lilywang899/gripper/README.md

# Gripper
Using two [KGM1024-N20](https://www.kindmotor.com/sale-26563852-micro-parallel-axis-shaft-dc-motor-180mnm-2-2w-right-angle-gear-reducer-motor.html) motors,
 resistive position sensors, and ESP32 controller, the gripper interfaces with a robotic arm to grasp small objects.

#### Detailed PCB soldering and troubleshooting process can be found [here](./hardware/README.md)
