lilywang899/gripper/3D-model/case.SLDPRT

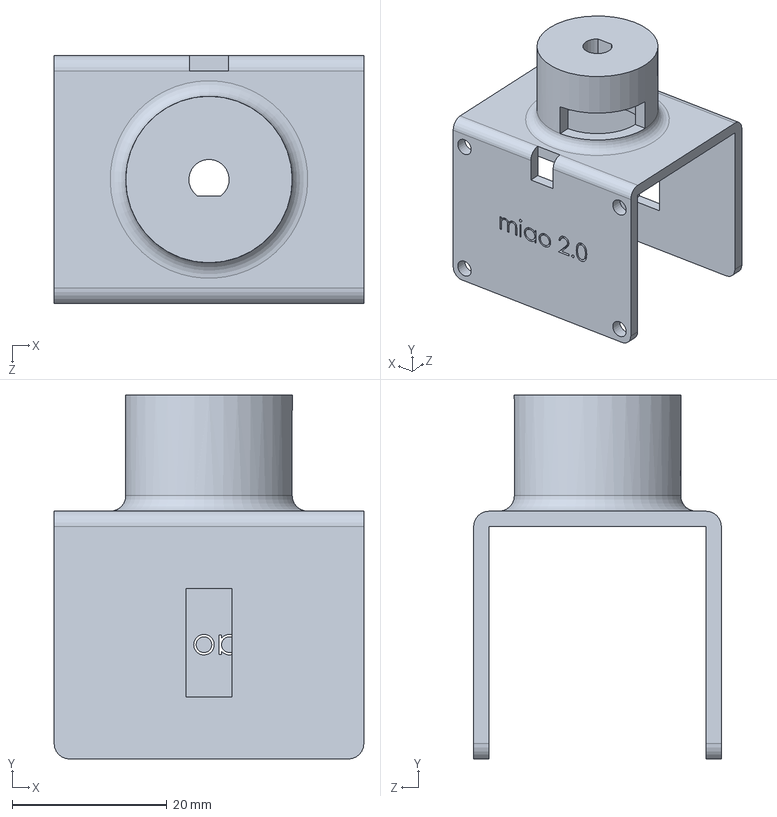
[picture p4: CAD file, 2025-09-13]
3D-model/case.SLDPRT
40.0 x 47.0 x 32.0 mm
