lilywang899/gripper/3D-model/collar_clamp_for_case.SLDPRT

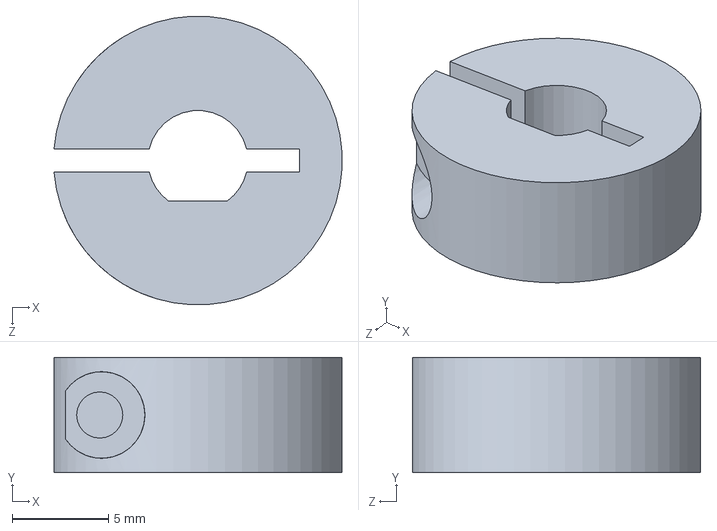
[picture p5: CAD file, 2025-09-13]
3D-model/collar_clamp_for_case.SLDPRT
15.0 x 6.00 x 15.0 mm
