lilywang899/gripper/3D-model/finger.SLDPRT

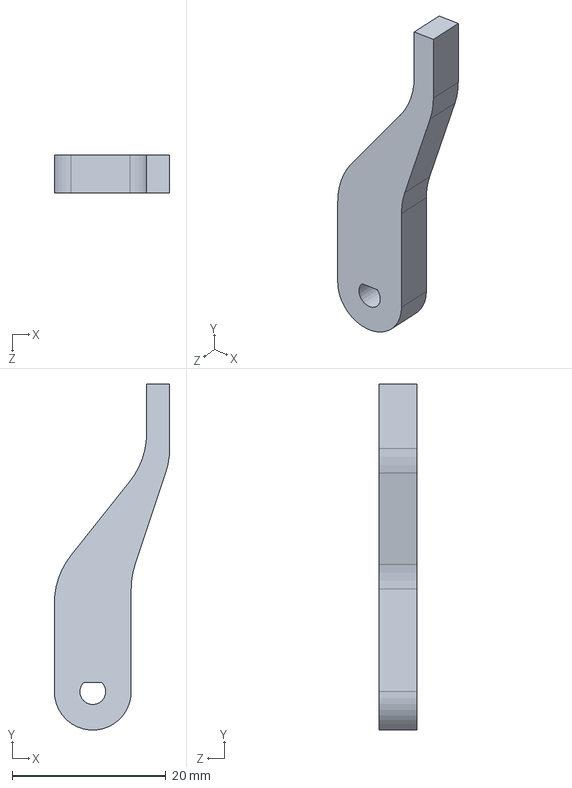
[picture p6: CAD file, 2025-09-13]
3D-model/finger.SLDPRT
15.0 x 45.0 x 5.00 mm
