lilywang899/gripper/(list of files, cad)

Other CAD files:
3D-model/case.STL
3D-model/collar_clamp_for_case.STL
3D-model/finger.STL
