lilywang899/gripper/(list of files, drawings)

Other design files:
hardware/Main.SchDoc
