lilywang899/gripper/main/console_settings.c

#include <stdio.h>
#include <string.h>
#include <unistd.h>
#include <fcntl.h>
#include "esp_system.h"
#include "esp_log.h"
#include "esp_console.h"
#include "sdkconfig.h"
#include "soc/soc_caps.h"
#include "driver/uart_vfs.h"
#include "driver/uart.h"
#include "linenoise/linenoise.h"
#include "argtable3/argtable3.h"

#define CONSOLE_MAX_CMDLINE_ARGS 8
#define CONSOLE_MAX_CMDLINE_LENGTH 256
#define CONSOLE_PROMPT_MAX_LEN (32)

char prompt[CONSOLE_PROMPT_MAX_LEN]; // Prompt to be printed before each line

void initialize_console_peripheral(void)
{
    /* Drain stdout before reconfiguring it */
    fflush(stdout);
    fsync(fileno(stdout));

    /* Minicom, screen, idf_monitor send CR when ENTER key is pressed */
    uart_vfs_dev_port_set_rx_line_endings(CONFIG_ESP_CONSOLE_UART_NUM, ESP_LINE_ENDINGS_CR);
    /* Move the caret to the beginning of the next line on '\n' */
    uart_vfs_dev_port_set_tx_line_endings(CONFIG_ESP_CONSOLE_UART_NUM, ESP_LINE_ENDINGS_CRLF);

    /* Configure UART. Note that REF_TICK is used so that the baud rate remains
     * correct while APB frequency is changing in light sleep mode.
     */
    const uart_config_t uart_config = {
            .baud_rate = CONFIG_ESP_CONSOLE_UART_BAUDRATE,
            .data_bits = UART_DATA_8_BITS,
            .parity = UART_PARITY_DISABLE,
            .stop_bits = UART_STOP_BITS_1,
    };
    /* Install UART driver for interrupt-driven reads and writes */
    ESP_ERROR_CHECK( uart_driver_install(CONFIG_ESP_CONSOLE_UART_NUM, 256, 0, 0, NULL, 0) );
    ESP_ERROR_CHECK( uart_param_config(CONFIG_ESP_CONSOLE_UART_NUM, &uart_config) );

    /* Tell VFS to use UART driver */
    uart_vfs_dev_use_driver(CONFIG_ESP_CONSOLE_UART_NUM);



    /* Disable buffering on stdin */
    setvbuf(stdin, NULL, _IONBF, 0);
}

void initialize_console_library(const char *history_path)
{
    /* Initialize the console */
    esp_console_config_t console_config = {
            .max_cmdline_args = CONSOLE_MAX_CMDLINE_ARGS,
            .max_cmdline_length = CONSOLE_MAX_CMDLINE_LENGTH
    };
    ESP_ERROR_CHECK( esp_console_init(&console_config) );

    /* Configure linenoise line completion library */
    /* Enable multiline editing. If not set, long commands will scroll within
     * single line.
     */
    linenoiseSetMultiLine(1);

    /* Tell linenoise where to get command completions and hints */
    linenoiseSetCompletionCallback(&esp_console_get_completion);
    linenoiseSetHintsCallback((linenoiseHintsCallback*) &esp_console_get_hint);

    /* Set command history size */
    linenoiseHistorySetMaxLen(100);

    /* Set command maximum length */
    linenoiseSetMaxLineLen(console_config.max_cmdline_length);

    /* Don't return empty lines */
    linenoiseAllowEmpty(false);

    /* Load command history from filesystem */
    linenoiseHistoryLoad(history_path);

    /* Figure out if the terminal supports escape sequences */
    const int probe_status = linenoiseProbe();
    if (probe_status) {         /* zero indicates success */
        linenoiseSetDumbMode(1);
    }
}

char *setup_prompt(const char *prompt_str)
{
    /* set command line prompt */
    const char *prompt_temp = "esp>";
    if (prompt_str) {
        prompt_temp = prompt_str;
    }
    snprintf(prompt, CONSOLE_PROMPT_MAX_LEN - 1, LOG_COLOR_I "%s " LOG_RESET_COLOR, prompt_temp);

    if (linenoiseIsDumbMode()) {
#if CONFIG_LOG_COLORS
        /* Since the terminal doesn't support escape sequences,
         * don't use color codes in the s_prompt.
         */
        snprintf(prompt, CONSOLE_PROMPT_MAX_LEN - 1, "%s ", prompt_temp);
#endif //CONFIG_LOG_COLORS
    }
    return prompt;
}
