lilywang899/gripper/(commit log)

2025-09-13 base code for gripper control
    [partitions.csv]
2025-09-13 updated README and added 3d-model designs
    [Main.SchDoc, case.SLDPRT, case.STL, collar_clamp_for_case.SLDPRT, collar_clamp_for_case.STL, finger.SLDPRT, finger.STL]
2025-09-22 testing scripts for motor controller and position sensor
